uw-ece475-542-f26-t9/embedded/(commit log)

2026-10-15 first imu test code
2026-10-21 Update setup delay and sensor data output for IMU
    Increased delay in setup and modified loop to print sensor data.
2026-10-23 James add code to test if ESP32 working
    [imu_test.ino]
2026-10-23 fatigue sensor with imu rep counter
2026-11-11 Added EMG capture mode (continuous ADC at 8 kHz, FIR decimation to 2 kHz, framed USB stream), turning-point stamps in the rep counter, and Python tools to record sets and analyse EMG fatigue features
2026-11-13 stop haptic buzzing constantly
    [fatigue_sensor.ino]
2026-11-13 Added an on-device fatigue model: per-rep EMG and IMU features, a small int8 neural network that estimates reps in reserve, a haptic alert, a training script and host tests
